kuro68k/Kicad-kuro68k-libraries/3D_Models/VEML7700.stp

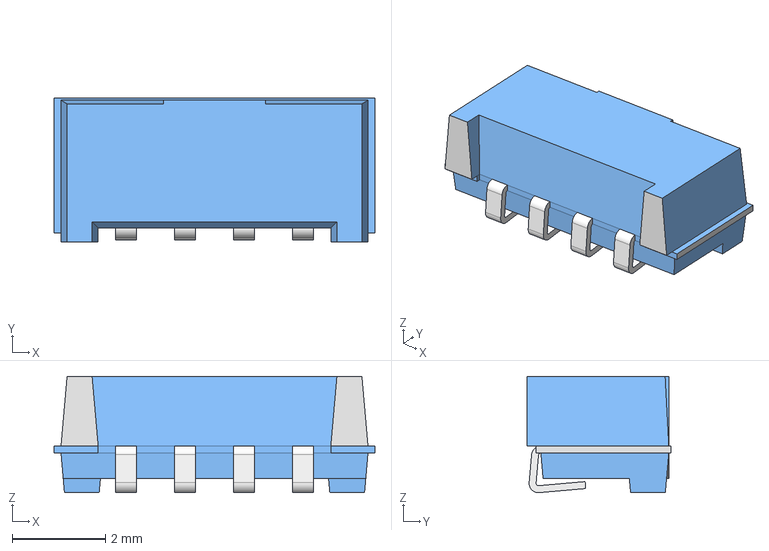
[picture p1: CAD file, 2025-11-10]
3D_Models/VEML7700.stp
6.90 x 3.10 x 2.50 mm
