kuro68k/Kicad-kuro68k-libraries/3D_Models/A-DS 09 A_KG-T4S.STEP

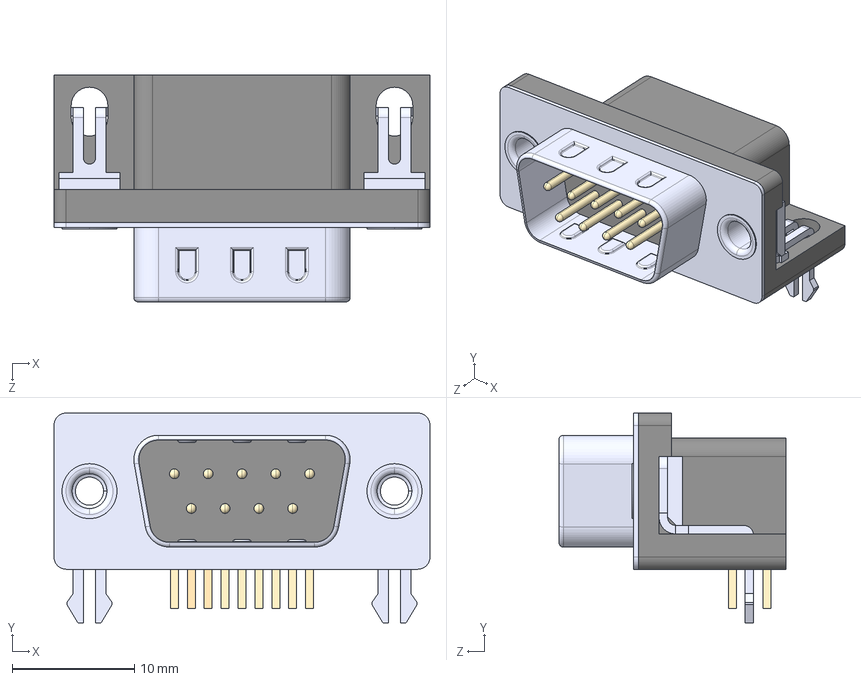
[picture p2: CAD file, 2025-11-10]
3D_Models/A-DS 09 A_KG-T4S.STEP
30.8 x 17.2 x 18.6 mm
