kuro68k/Kicad-kuro68k-libraries/3D_Models/7seg1inch.STEP

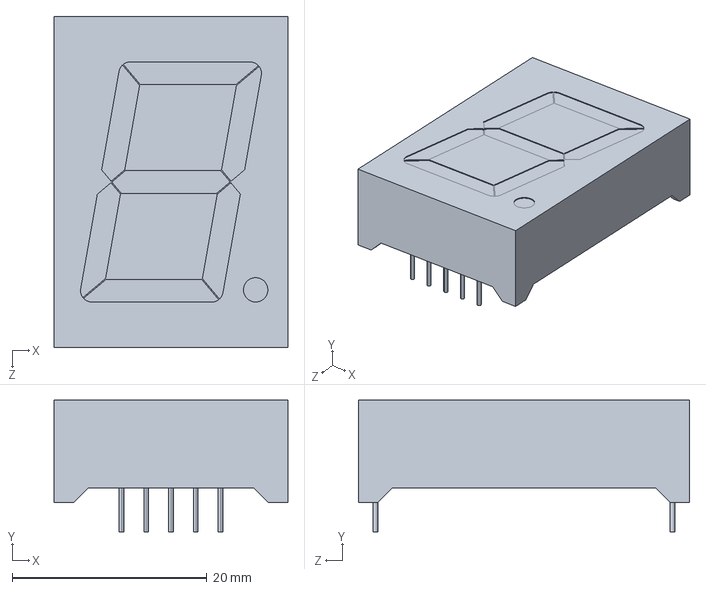
[picture p3: CAD file, 2025-11-10]
3D_Models/7seg1inch.STEP
24.0 x 13.5 x 34.0 mm
