kuro68k/Kicad-kuro68k-libraries/3D_Models/C&K_KSC641JLFS.stp

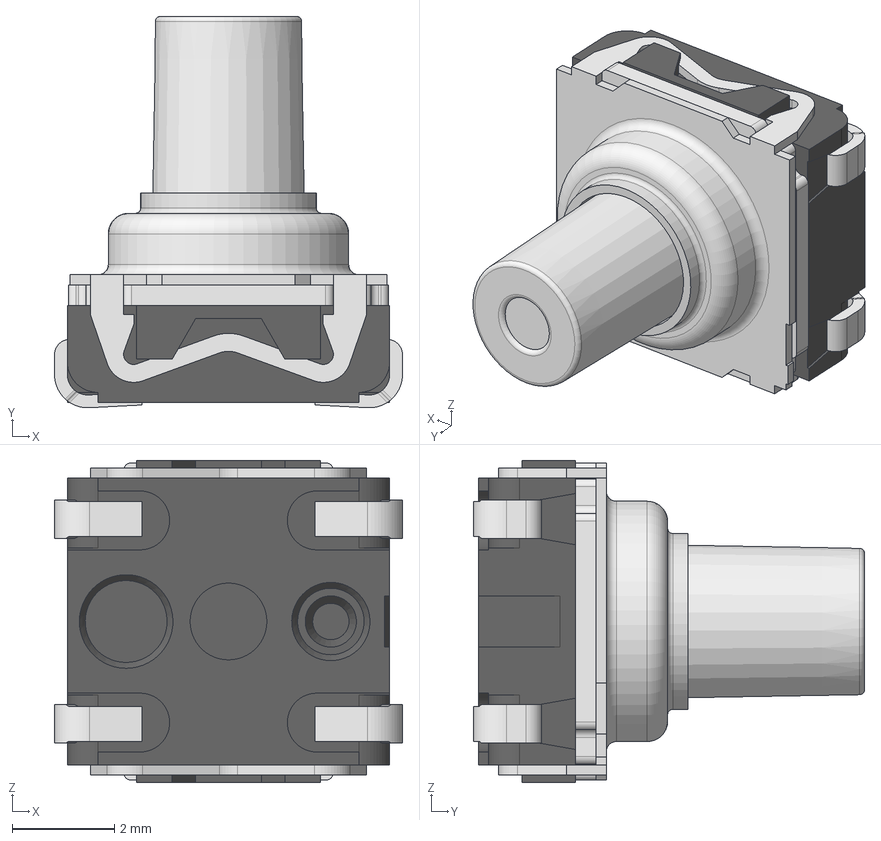
[picture p4: CAD file, 2024-08-27]
3D_Models/C&K_KSC641JLFS.stp
6.80 x 7.65 x 6.30 mm
KSC6 - body
KSC6 - button
KSC6 - cover
KSC61J_pin x 4
