kuro68k/Kicad-kuro68k-libraries/3D_Models/C&K_PTS641SP25SMTR2LFS.stp

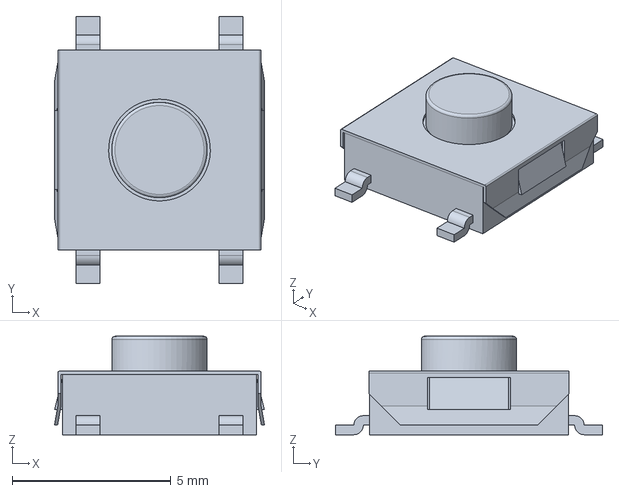
[picture p5: CAD file, 2024-08-27]
3D_Models/C&K_PTS641SP25SMTR2LFS.stp
6.61 x 8.40 x 3.10 mm
