kuro68k/Kicad-kuro68k-libraries/3D_Models/GCT USB4056-03-A.stp

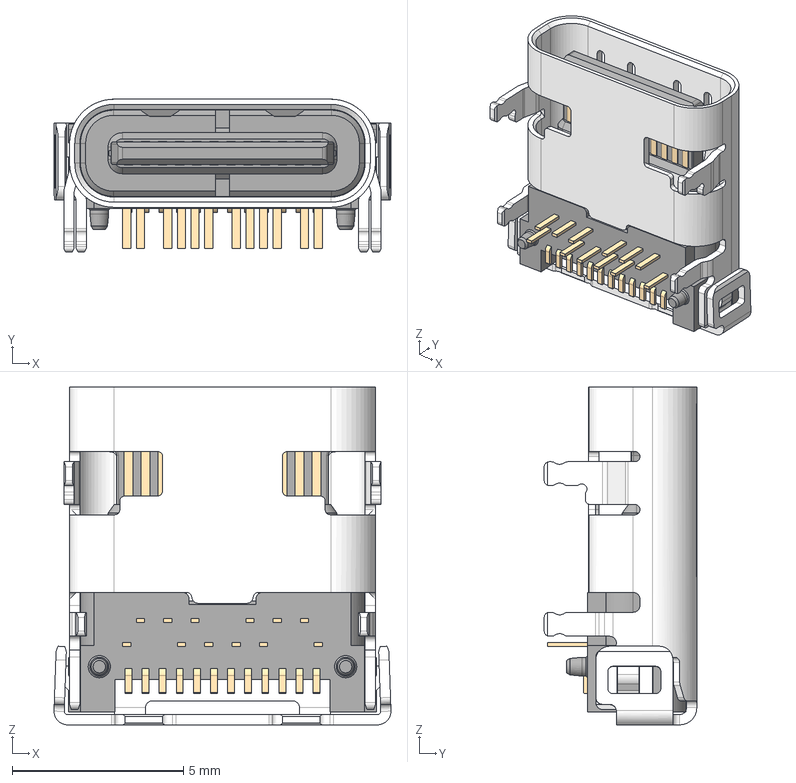
[picture p6: CAD file, 2024-08-22]
3D_Models/GCT USB4056-03-A.stp
9.85 x 4.46 x 9.87 mm
