kuro68k/Kicad-kuro68k-libraries/3D_Models/Female SCART connector ST107R-21.step

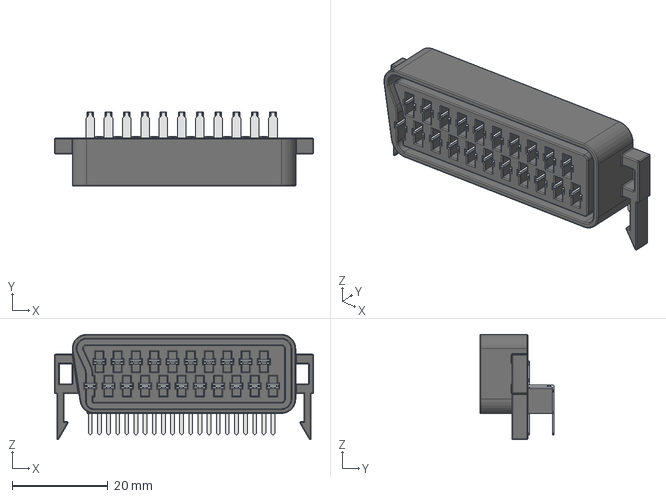
[picture p7: CAD file, 2024-04-19]
3D_Models/Female SCART connector ST107R-21.step
54.0 x 15.5 x 22.0 mm
