kuro68k/Kicad-kuro68k-libraries/3D_Models/62PC8FS.STEP

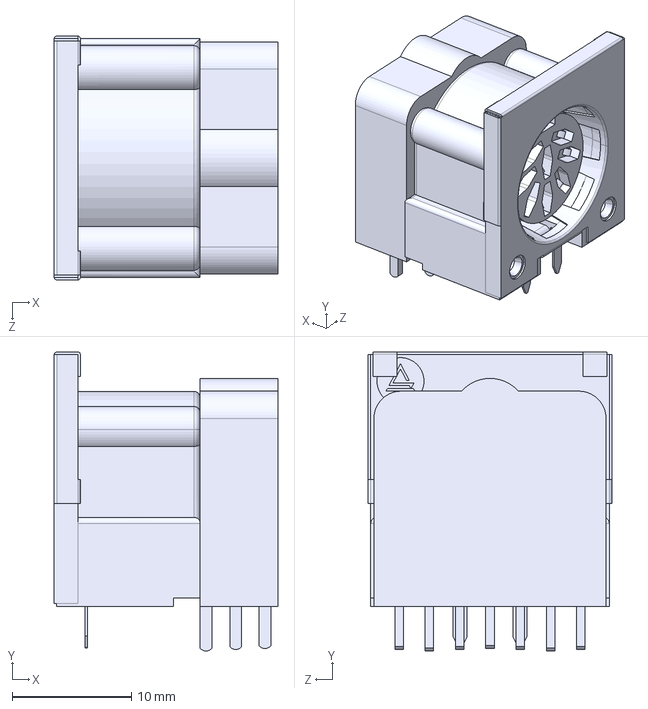
[picture p8: CAD file, 2024-04-19]
3D_Models/62PC8FS.STEP
18.7 x 25.0 x 20.4 mm
