kuro68k/Kicad-kuro68k-libraries/3D_Models/XKB SS13D75L5.stp

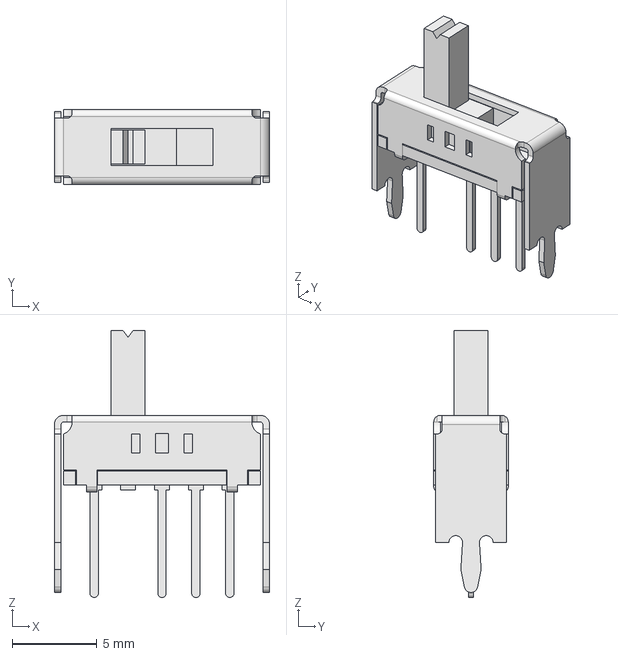
[picture p9: CAD file, 2024-02-19]
3D_Models/XKB SS13D75L5.stp
12.7 x 4.40 x 15.7 mm
