kuro68k/Kicad-kuro68k-libraries/3D_Models/Playstation Controller Socket (3rd party).step

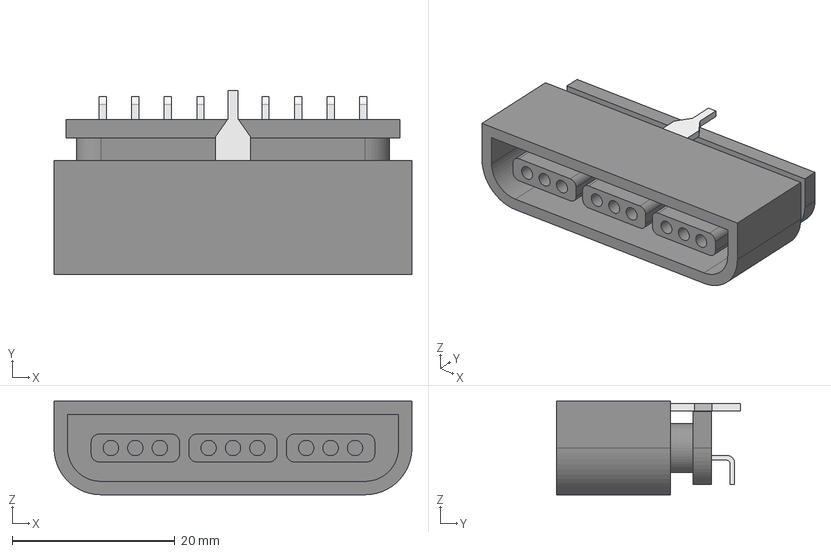
[picture p10: CAD file, 2024-02-19]
3D_Models/Playstation Controller Socket (3rd party).step
44.0 x 22.6 x 11.5 mm
Body Plastic Shell
Body Rear Contacts
Body Front Contact Shell
Body Rear Ground Contact
Sketch003
