kuro68k/Kicad-kuro68k-libraries/3D_Models/Saturn Controller Socket (3rd party).step

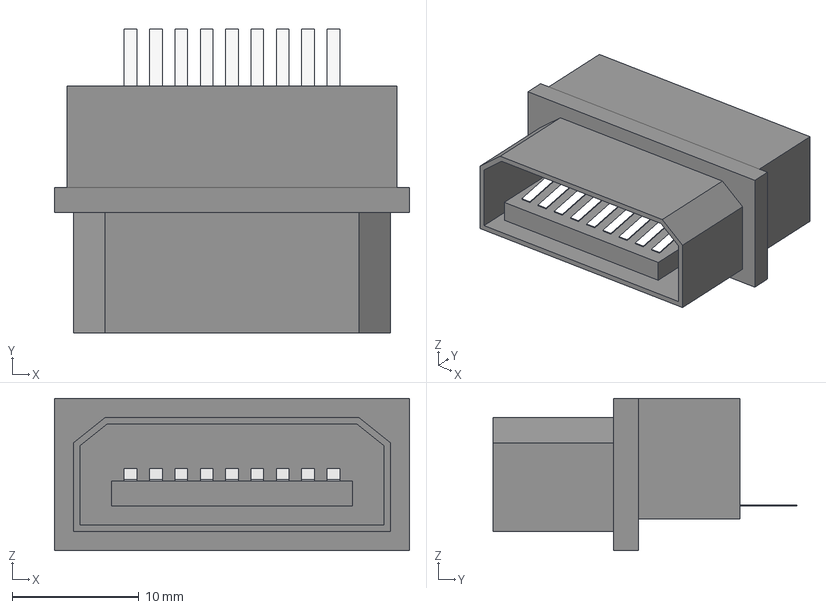
[picture p11: CAD file, 2024-02-19]
3D_Models/Saturn Controller Socket (3rd party).step
28.0 x 24.0 x 12.0 mm
Contact Shell
Contact Tongue
Strain Relief
Rear Contacts x 9
