kuro68k/Kicad-kuro68k-libraries/3D_Models/C&K_OS103011MS8QP1.stp

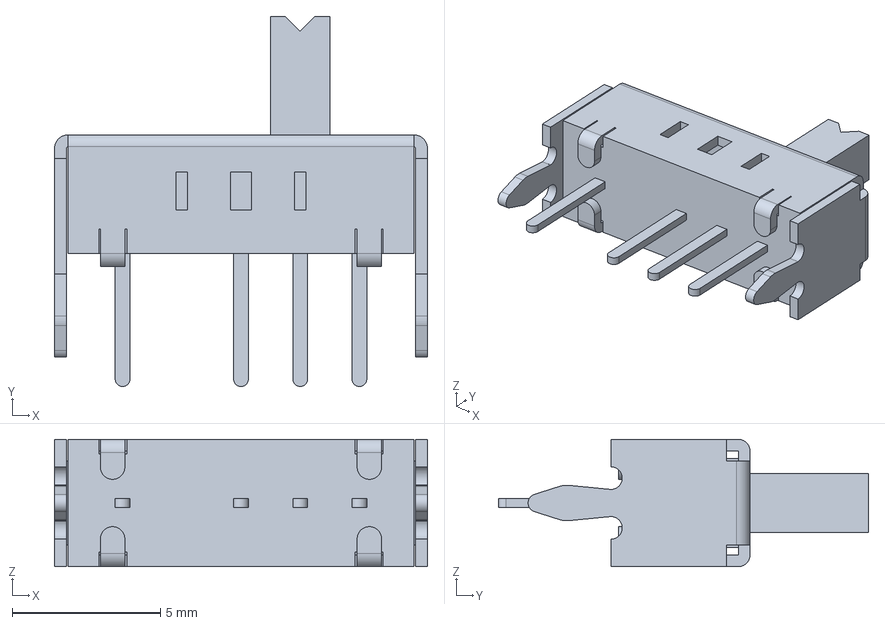
[picture p12: CAD file, 2024-02-13]
3D_Models/C&K_OS103011MS8QP1.stp
12.6 x 12.5 x 4.30 mm
