kuro68k/Kicad-kuro68k-libraries/3D_Models/AMP-TE c-350211-1-af-3d.stp

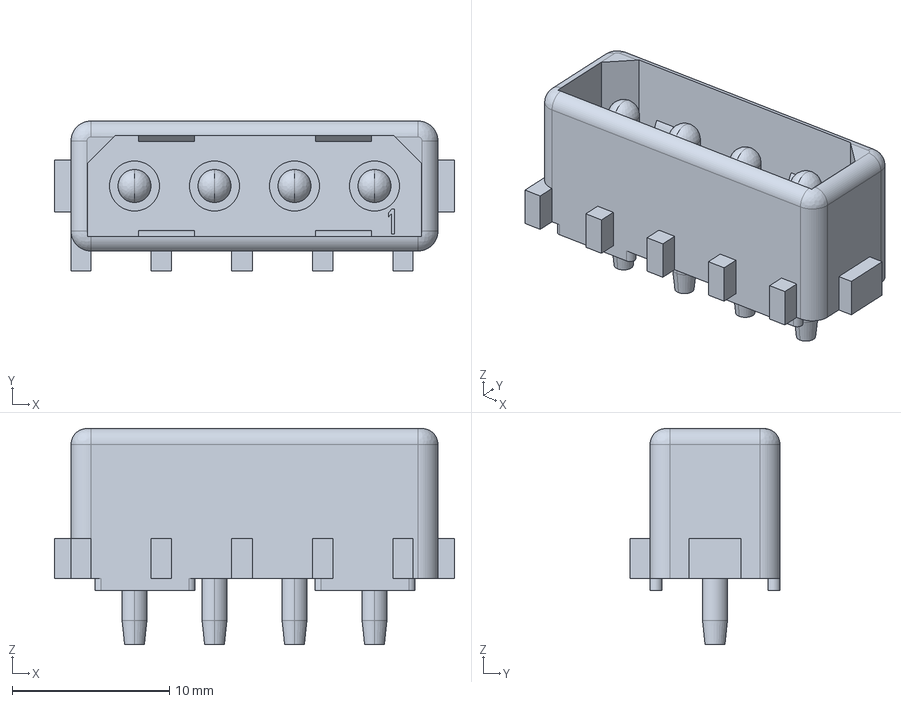
[picture p13: CAD file, 2023-07-31]
3D_Models/AMP-TE c-350211-1-af-3d.stp
25.4 x 9.53 x 13.7 mm
