kuro68k/Kicad-kuro68k-libraries/3D_Models/XKB DC-005-5A-2_0.stp

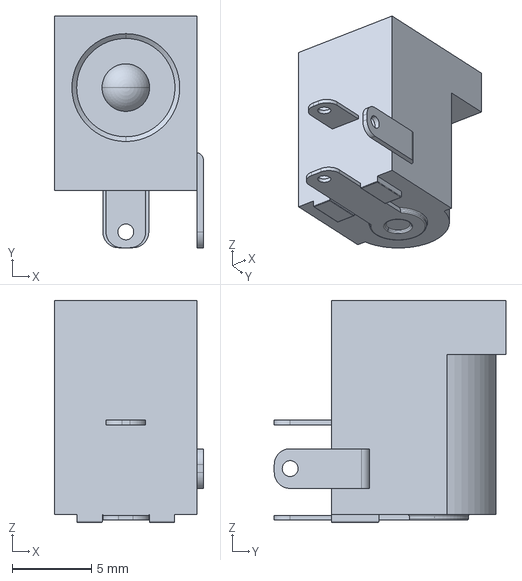
[picture p14: CAD file, 2023-07-31]
3D_Models/XKB DC-005-5A-2_0.stp
9.40 x 14.6 x 14.0 mm
