kuro68k/Kicad-kuro68k-libraries/3D_Models/GCT USB4105-GF-A.step

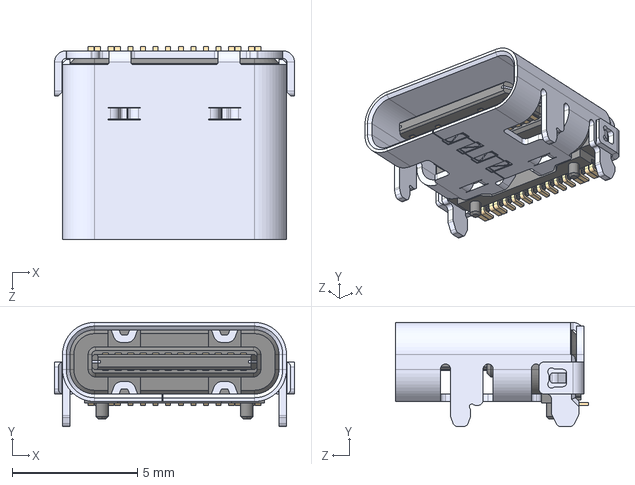
[picture p15: CAD file, 2023-07-31]
3D_Models/GCT USB4105-GF-A.step
9.58 x 4.16 x 7.71 mm
