kuro68k/Kicad-kuro68k-libraries/3D_Models/Wurth_693071020811 (rev1).stp

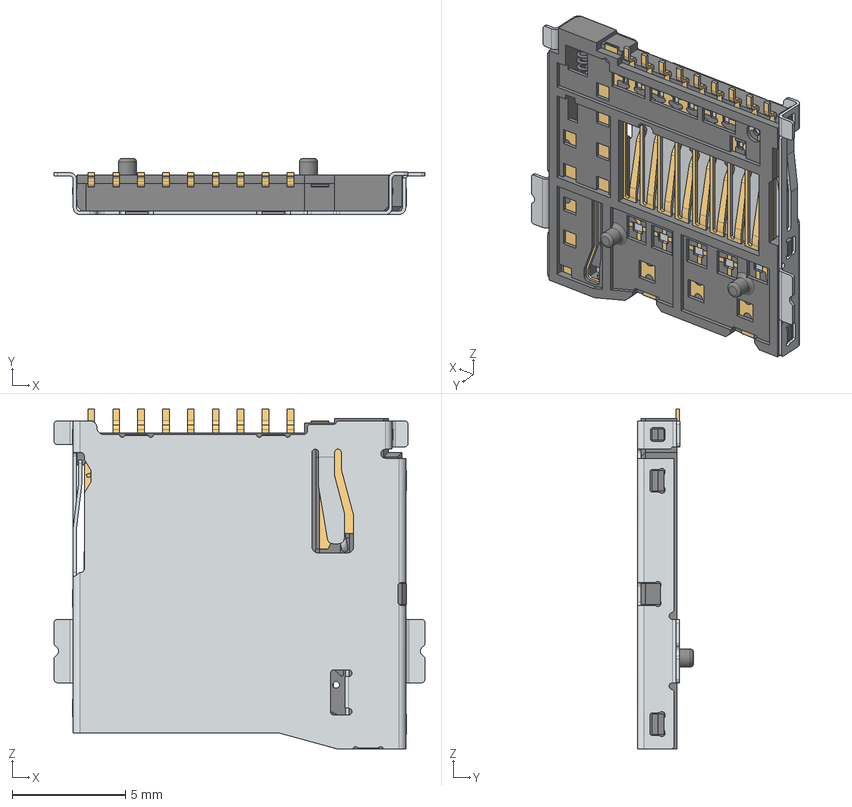
[picture p16: CAD file, 2023-07-31]
3D_Models/Wurth_693071020811 (rev1).stp
16.4 x 2.48 x 15.0 mm
693071020811_Housing
693071020811_Guide
693071020811_Spring
693071020811_Contact
693071020811_Hook
693071020811_Agraphe
693071020811_Shielding
