kuro68k/Kicad-kuro68k-libraries/3D_Models/E07-900M10S.step

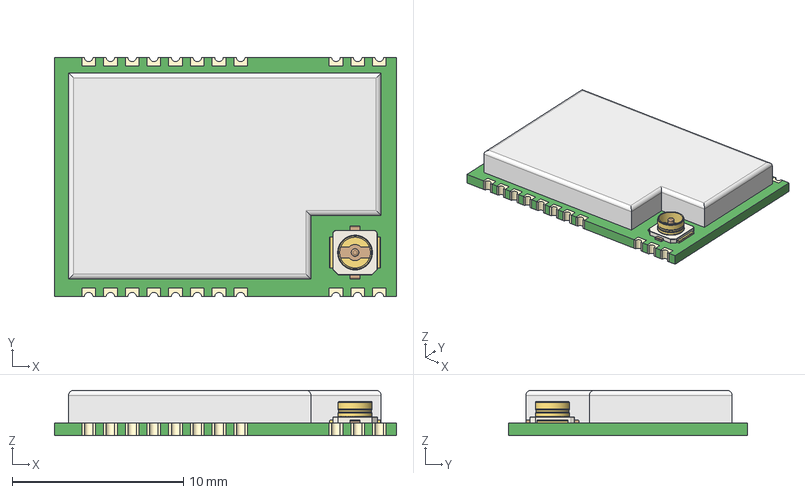
[picture p17: CAD file, 2023-07-31]
3D_Models/E07-900M10S.step
20.0 x 14.0 x 2.65 mm
