kuro68k/Kicad-kuro68k-libraries/3D_Models/AMP-TE c-770997-1-b-3d.stp

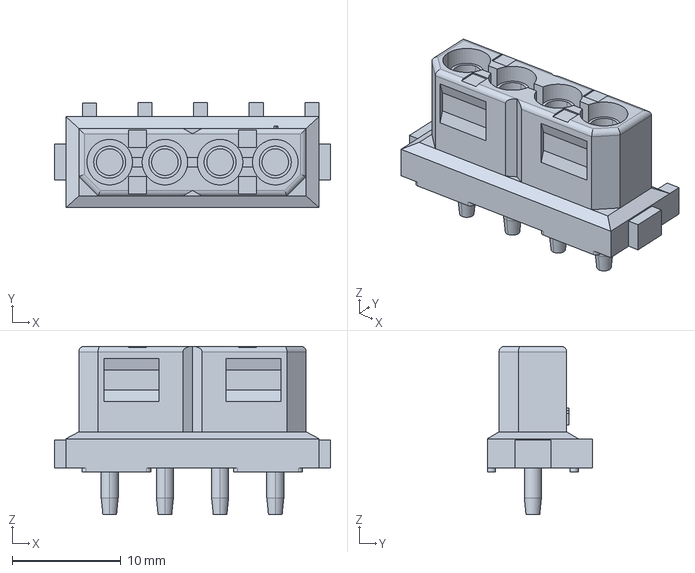
[picture p18: CAD file, 2023-07-31]
3D_Models/AMP-TE c-770997-1-b-3d.stp
25.4 x 9.70 x 15.5 mm
