kuro68k/Kicad-kuro68k-libraries/documentation/CTC SHILD SINGLE SCART 2202-21ST(B).pdf

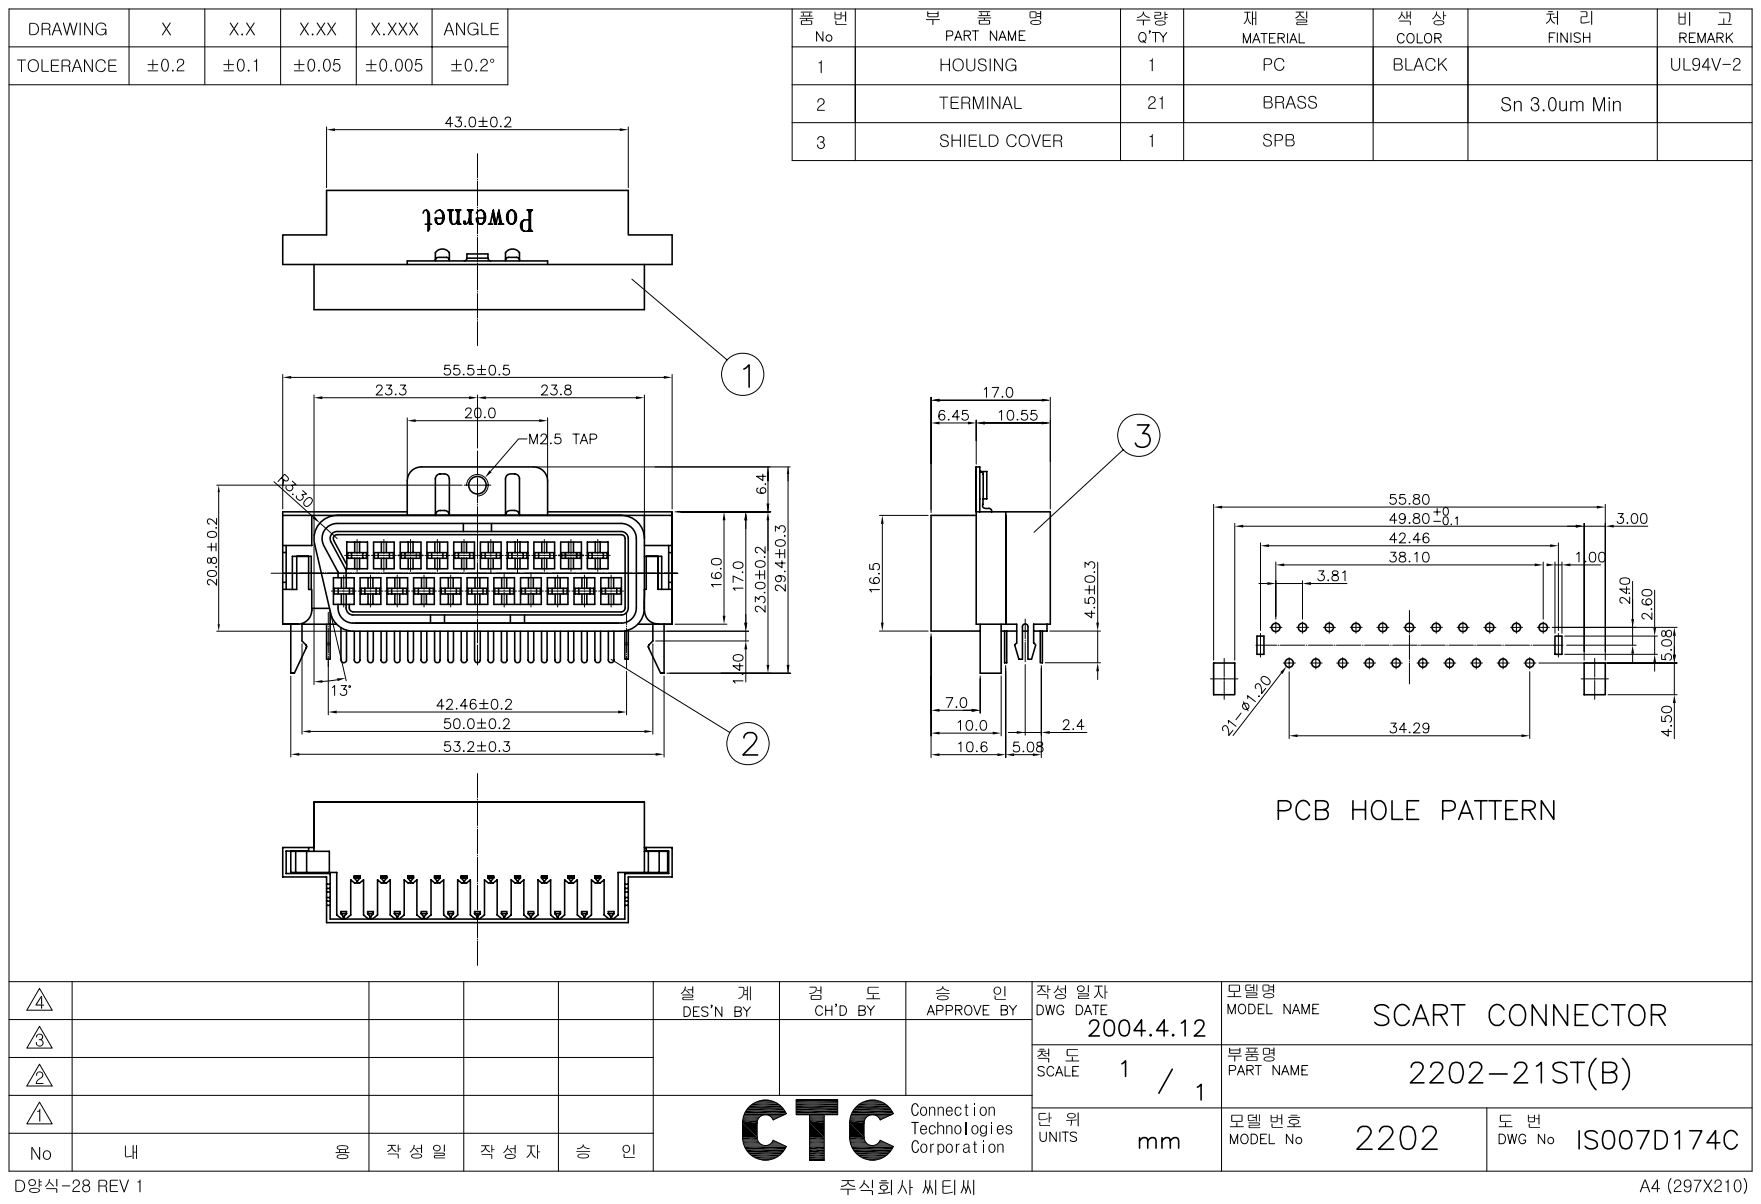
[picture p19: page 1]
