kuro68k/Kicad-kuro68k-libraries/(commit log)

2016-10-30 Added ASEK oscillator footprint
2016-10-31 Added various new footprints
2016-11-14 Added a few footprints
2016-11-14 Fixed multi xtal footprint duplicate pad 1
2017-05-11 Molex Micro USB connector
2017-05-12 JST ZR 2 pin + fixes, 4x2 1.27mm header
2017-07-03 Arduino Nano V3
2017-07-07 Pin numbering on DB9
2018-06-25 Added Bourns footprint
2018-06-28 SMD button
2023-07-31 Rohm light sensors added
2023-07-31 Various footprints from various projects
2023-07-31 GCT USB connectors
2023-07-31 Sensor modules
2023-07-31 Migrated to Kicad 7
2023-07-31 Added 3D models
    [AMP-TE c-350211-1-af-3d.stp, AMP-TE c-770997-1-b-3d.stp, E07-900M10S.step, GCT USB4105-GF-A.step, Wurth_693071020811 (rev1).stp, XKB DC-005-5A-2_0.stp]
2023-08-28 Fixed for KiCad 7
2024-02-13 Added C&K slide switch
    [C&K_OS103011MS8QP1.stp]
2024-02-19 Saturn/PS 3rd party connectors
    [Playstation Controller Socket (3rd party).step, Saturn Controller Socket (3rd party).step]
2024-02-19 Slide switches
    [XKB SS13D75L5.stp]
2024-04-19 DIN and SCART connectors
    [62PC8FS.STEP, Female SCART connector ST107R-21.step]
2024-08-22 Added GCT USB C sockets
    [GCT USB4056-03-A.stp]
2024-08-22 Added 6x2mm crystal footprint
2024-08-27 C&K push buttons
    [C&K_KSC641JLFS.stp, C&K_PTS641SP25SMTR2LFS.stp]
2025-11-10 Medium size 7 seg displays
    [7seg1inch.STEP]
2025-11-10 Assmann D-Sub connectors
    [A-DS 09 A_KG-T4S.STEP]
2025-11-10 Ambient light sensor
    [VEML7700.stp]
