kuro68k/Kicad-kuro68k-libraries/(notices)

Notices in the files:
3D_Models/GCT USB4056-03-A.stp:
author */ ('License CC BY-ND 4.0'),
